Timonas04/adc_dac2/(commit log)

2024-11-04 default layout
    [compr.sch, compr_tb.sch, flash_adc.sch, pass_gate2_tb.sch, pass_gate_tb.sch, r2r_dac.sch, r2r_dac_tb.sch]
2024-11-04 added encoder mag file
2024-11-04 flash adc added
2024-11-05 rm port dir
    [tile_pinout.sch, top_tb.sch]
2024-11-05 flash adc
2024-11-05 flash adc no wires
    [top_tb.sch]
2024-11-05 routed flash adc
2024-11-05 complete adc wiring
    [top_tb.sch]
2024-11-06 only encoder
2024-11-06 just encoder
2024-11-06 new comparators
    [compr2.sch, compr2_tb.sch, top_tb.sch]
2024-11-06 imported resistors
2024-11-06 adc routed
2024-11-06 transmmision gates added
    [top_tb.sch]
2024-11-07 erasing some pin connections
2024-11-07 dac adc done
    [top_tb.sch]
2024-11-07 sti added
    [sti.sch, tnand.sch, tnand_tb.sch, top_tb.sch]
2024-11-07 everything together
    [tnand_tb.sch, top_tb.sch]
2024-11-07 no floaties
    [top_tb.sch]
